rekursiv/stepperature/hardware/kicad/publish/OSHPark-rev1.png

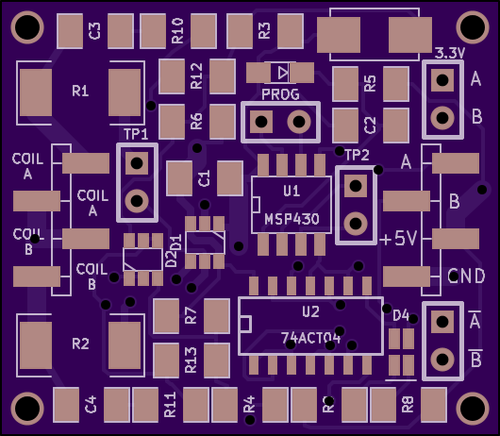
hardware/kicad/publish/OSHPark-rev1.png
