rekursiv/stepperature/hardware/kicad/publish/OSHPark-rev2-back.png

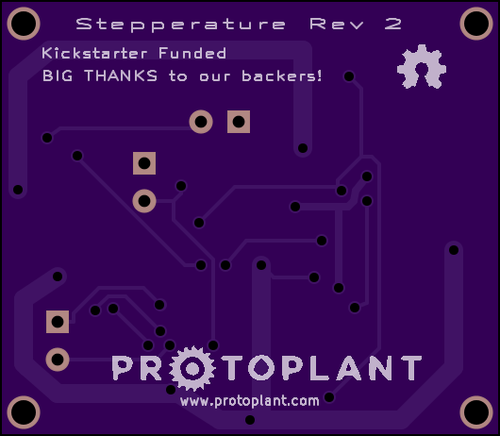
hardware/kicad/publish/OSHPark-rev2-back.png
