rekursiv/stepperature/hardware/kicad/publish/OSHPark-rev2-front.png

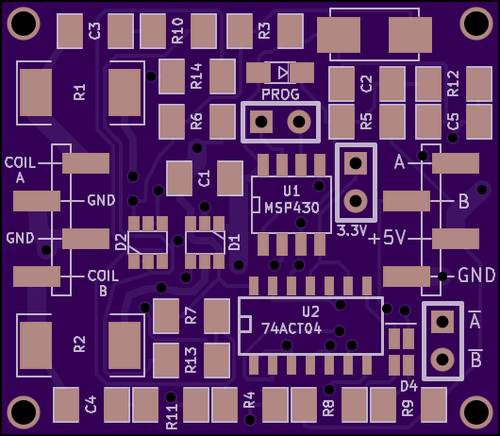
hardware/kicad/publish/OSHPark-rev2-front.png
