rekursiv/stepperature/hardware/kicad/publish/stepperature-schem.png

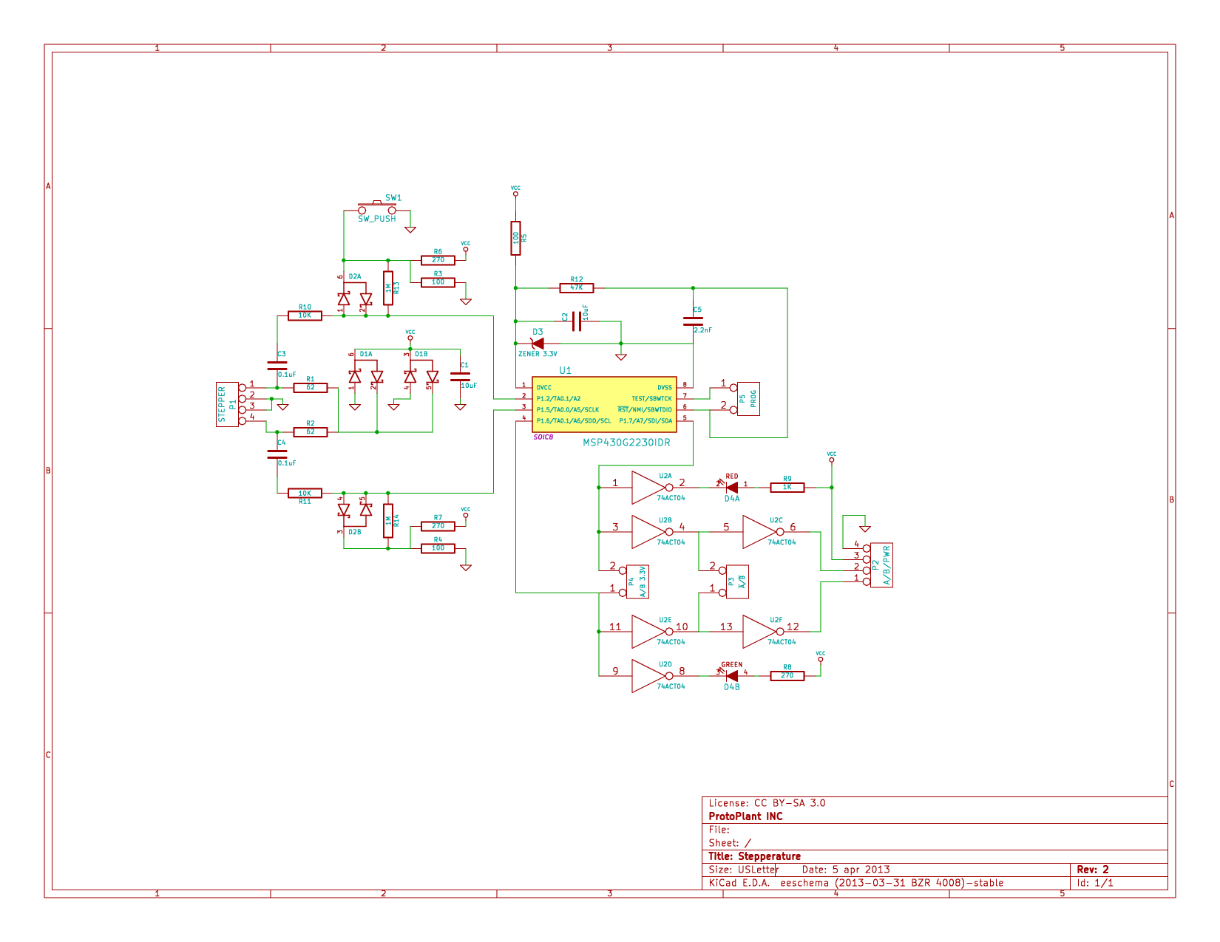
hardware/kicad/publish/stepperature-schem.png
