rekursiv/stepperature/(list of files, cad)

Other CAD files:
hardware/kicad/fab/stepperature-F_Paste.dxf
