rekursiv/stepperature/hardware/kicad/publish/stepperature-schem.pdf

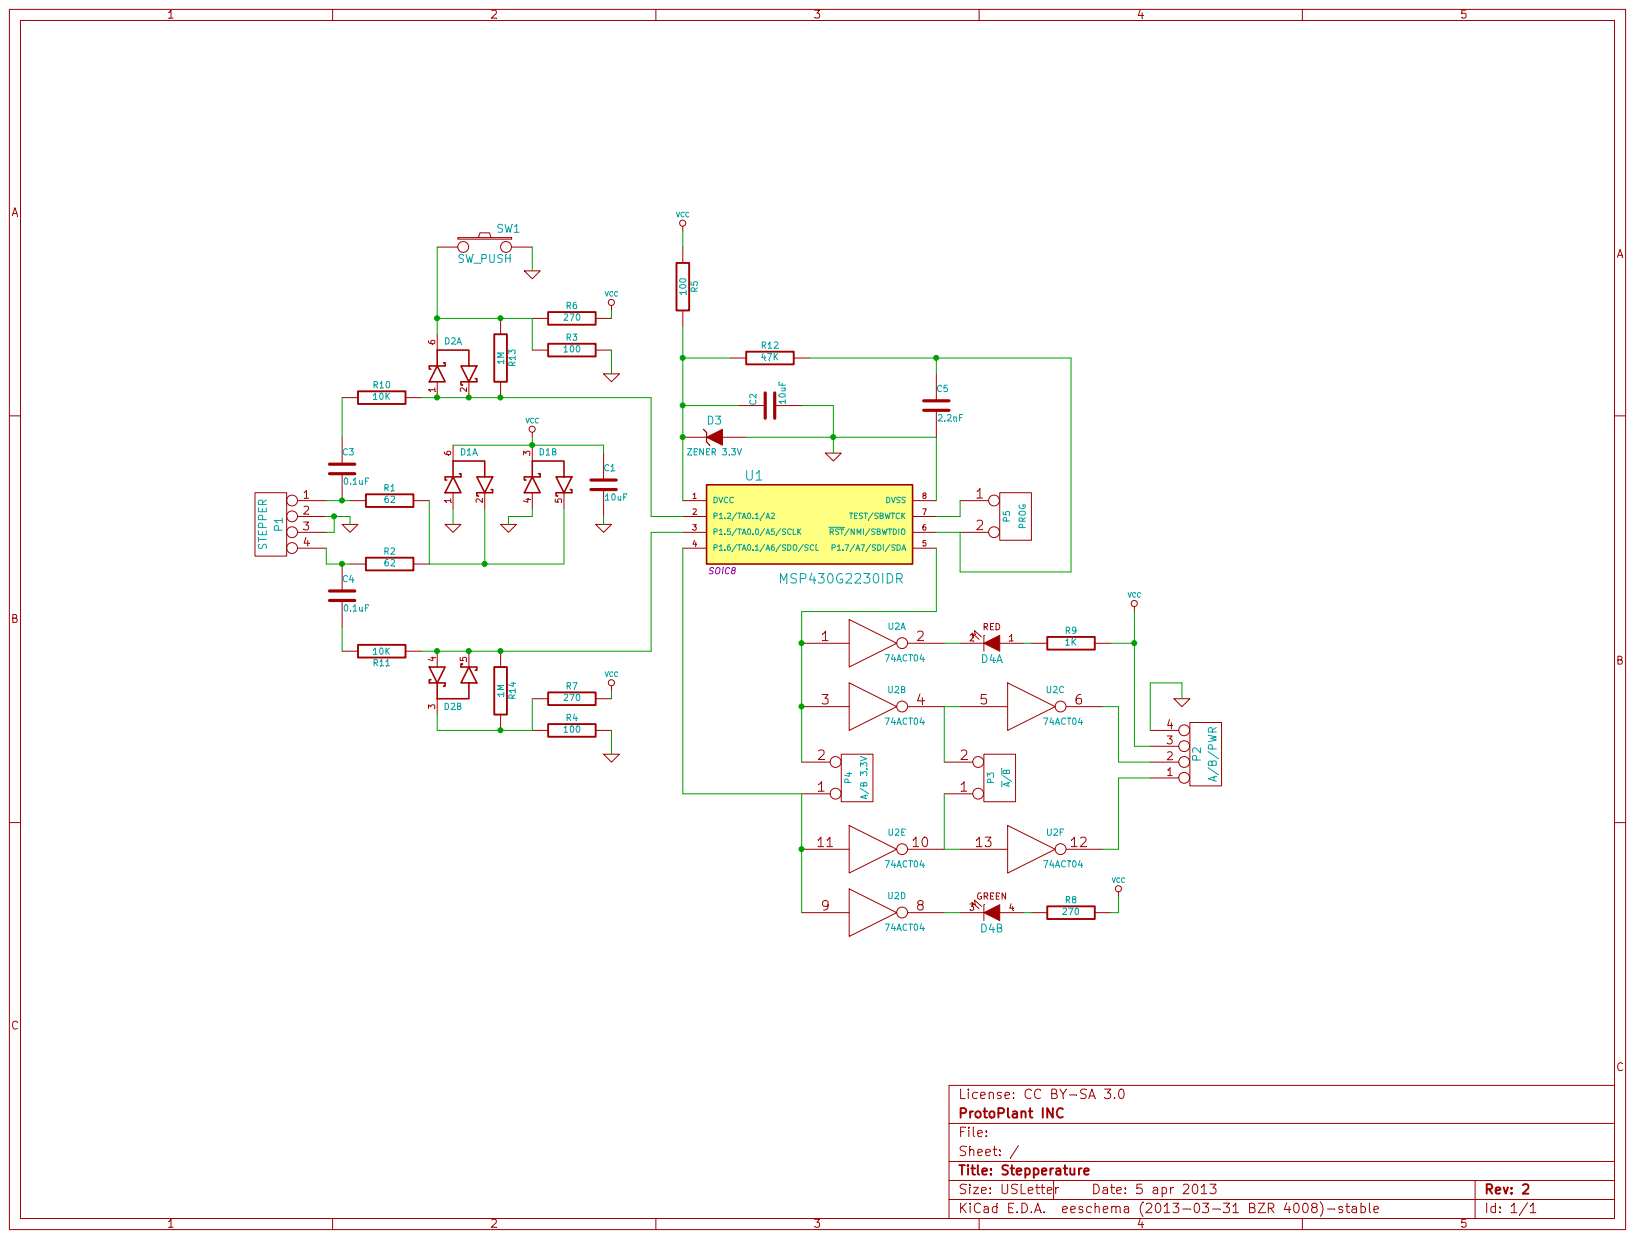
[picture p5: page 1]
