rekursiv/stepperature/(list of files, drawings)

Other design files:
hardware/kicad/stepperature.dsn
