rekursiv/stepperature/(commit log)

2013-03-11 added schematic
    [stepperature.sch]
2013-03-11 added power input to schematic
    [stepperature.sch]
2013-03-14 tweaked component values, added output stage
    [stepperature.sch]
2013-03-14 reworked to use diode arrays
    [stepperature.sch]
2013-03-15 added dual LED, finished annotations
    [stepperature.sch]
2013-03-15 lost in the ratsnest...
    [stepperature.dsn, stepperature.kicad_pcb, stepperature.sch]
2013-03-16 initial layout
    [stepperature.kicad_pcb, stepperature.sch]
2013-03-16 better layout
    [stepperature.dsn, stepperature.kicad_pcb]
2013-03-16 almost ready to fab
    [stepperature.dsn, stepperature.kicad_pcb]
2013-03-16 added cathode mark to LEDs
    [stepperature.kicad_pcb]
2013-03-16 add mounting holes
    [stepperature.kicad_pcb]
2013-03-17 rev 1 sent to fab
    [stepperature-B_Cu.gbl, stepperature-B_Mask.gbs, stepperature-B_SilkS.gbo, stepperature-Edge_Cuts.gbr, stepperature-F_Cu.gtl, stepperature-F_Mask.gts, stepperature-F_SilkS.gto, stepperature.drl]
2013-03-17 fix backward LEDs
    [stepperature.kicad_pcb, stepperature.sch]
2013-04-04 new layout for rev2
    [stepperature.dsn, stepperature.kicad_pcb, stepperature.sch]
2013-04-04 add logo/text to back
    [stepperature.kicad_pcb]
2013-04-05 tweaks here n there
    [stepperature.kicad_pcb, stepperature.sch]
2013-04-05 rev2 almost ready...
    [stepperature.kicad_pcb]
2013-04-05 Rev 2 ready for fab!
    [stepperature-B_Cu.gbl, stepperature-B_Mask.gbs, stepperature-B_SilkS.gbo, stepperature-Edge_Cuts.gbr, stepperature-F_Cu.gtl, stepperature-F_Mask.gts, stepperature-F_SilkS.gto, stepperature.drl]
2013-04-05 added BOM
2013-04-28 state/calibration is now saved to and read from flash ram
2013-04-29 added license info
    [stepperature-F_Paste.dxf, stepperature.kicad_pcb, stepperature.sch]
2013-04-30 fixed serial mode flash read bug
    [main.c]
2013-05-09 update schematic pdf/png
