rekursiv/stepperature/(notices)

Notices in the files:
hardware/kicad/stepperature.kicad_pcb:
License: CC BY-SA 3.0
